fadli0029/Light-Following-Arm/images/challenge5.1.png

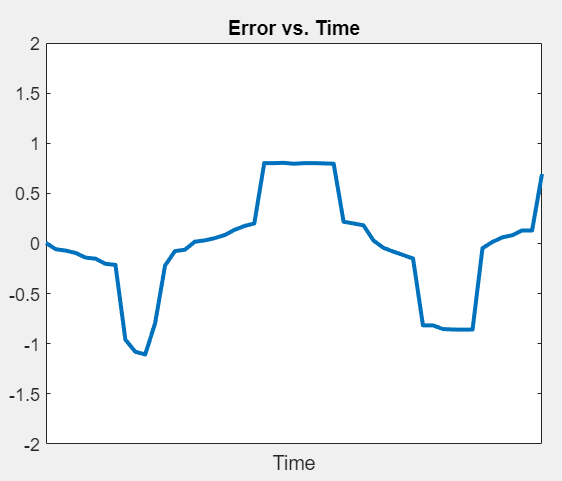
images/challenge5.1.png
