fadli0029/Light-Following-Arm/images/challenge 3.png

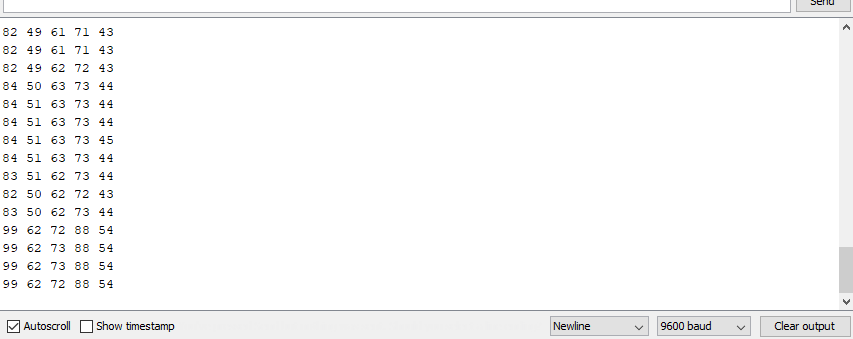
images/challenge 3.png
