fadli0029/Light-Following-Arm/images/challenge 4.3.jpeg

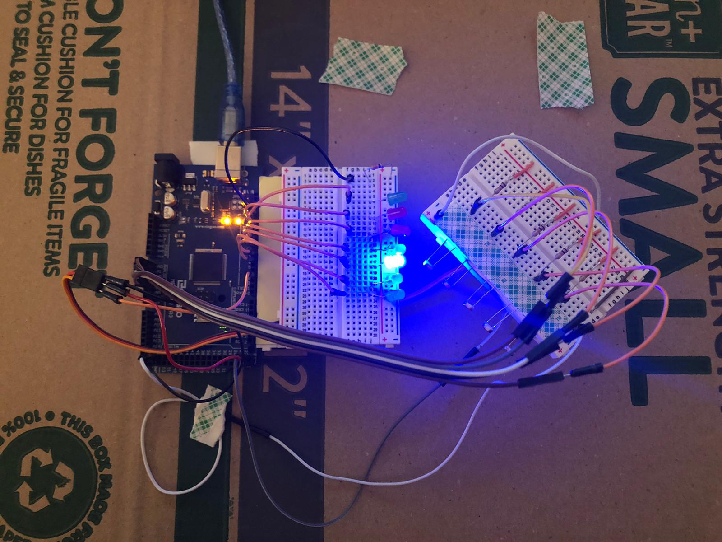
images/challenge 4.3.jpeg
