fadli0029/Light-Following-Arm/images/challenge 4.png

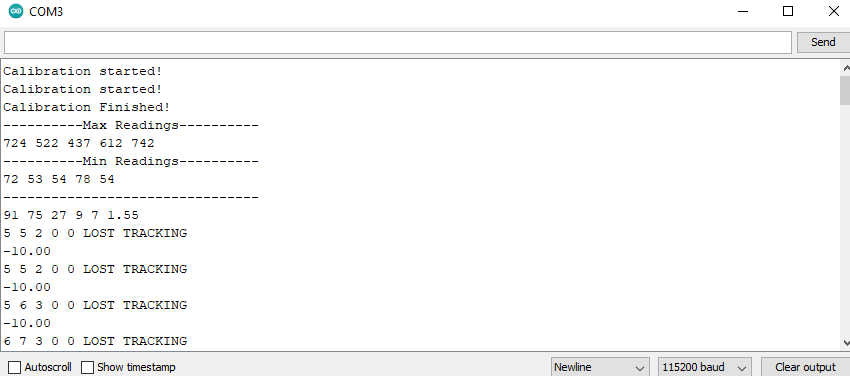
images/challenge 4.png
