fadli0029/Light-Following-Arm/images/challenge 5.3.png

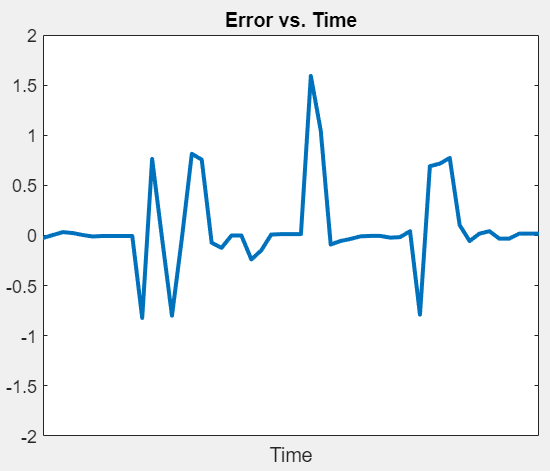
images/challenge 5.3.png
