fadli0029/Light-Following-Arm/images/challenge 5.png

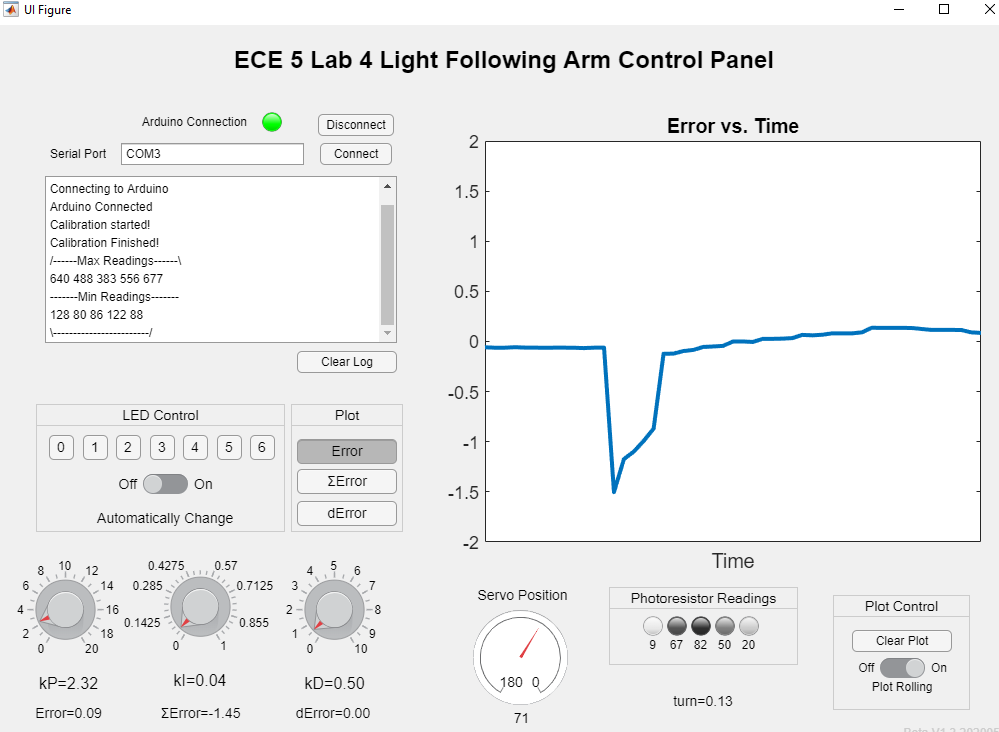
images/challenge 5.png
