fadli0029/Light-Following-Arm/images/screenshot of matlab gui graphing the error curve.png

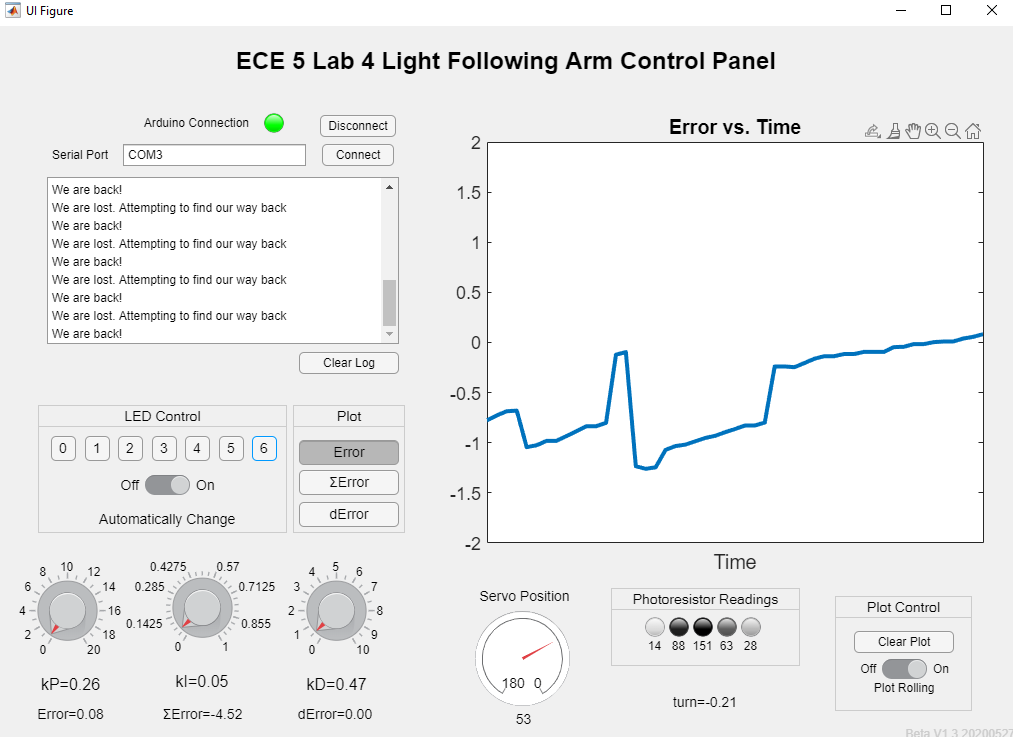
images/screenshot of matlab gui graphing the error curve.png
